skyformat99/IoT256/V2.0.1/doc/结构尺寸.jpg

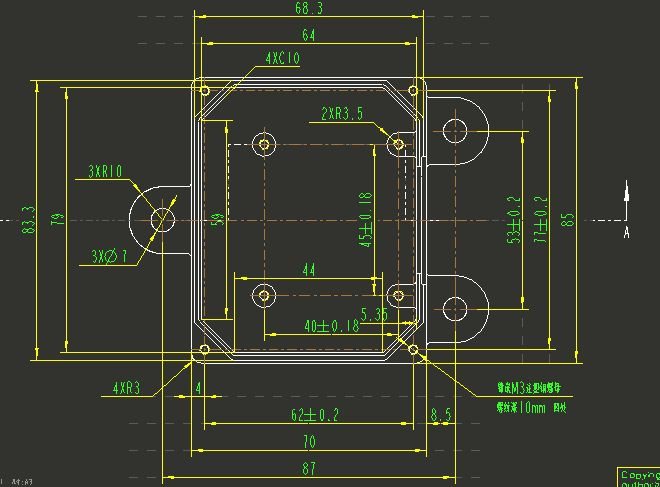
V2.0.1/doc/结构尺寸.jpg
