skyformat99/IoT256/V2.0.1/sch/versionLog.txt

1.PTA4 不能用，系统NMI pin

2. WIFI 16脚接地 （IO15）

3. PTC0图纸方向画反了

4. GPS 天线改成有源 
5.缺少B340A， 54331不工作。
6. R6 改小。 有时候串口输入低电平降不下来。0 欧？
RS232电平转换芯片处于工作状态输出或高或低，会影响HOST电平。低电平异常，可尝试再MCU端对地接个电阻试下。 

TPS54331D 6pin接地电阻为49.9K，图中为4.99K
