skyformat99/IoT256/V1.0.2/doc/VersionLog.txt

1. 在原来TPS54331输出电压3.5V基础上增加到3.8V，3K电阻并24k
2. 输出增加负载160ohm 0805电阻
3. 输出电容47uF x 2

复位电路
拆R17，U5_P8接U1_P26
