skyformat99/IoT256/V2.0.1/sch/IoT module_V2.0.1_BOM.xlsx

IoT module_V2.0.1_BOM
DNP:Do Not Place,不需配料焊接！
序号 | 数量 | 位号 | 型号 | 数值 | 描述 | 厂家 | DNP
1 | 4 | C1,C2,C3,C4 | CL05C270JB5NNNC | 270 | 27pF, 50V, 0402, COG, 5% | SAMSUNG | DNP
2 | 4 | C5,C6,C23,C24 | CL32A476KOJNNNE | 476 | 47uF, 16V,1210, X5R, 10% | SAMSUNG
3 | 1 | C7 | CL10A105KO8NNNC | 105 | 1uF, 16V, 0603, X5R, 10% | SAMSUNG
4 | 14 | C8,C9,C13,C17,C19,C25,C26,C28,C33,C35,C36,C42,C44,C45 | CL05B104KO5NNNC | 104 | 100nF, 16V, 0402, X7R, 10% | SAMSUNG
5 | 6 | C10,C11,C12,C14,C15,C16 | CL05C220JB5NNNC | 220 | 22pF, 50V, 0402, COG, 5% | SAMSUNG
6 | 3 | C18,C40,C41 | CL10A106MP8NNNC | 106 | 10uF, 10V, 0603, X5R, 20% | SAMSUNG
7 | 4 | C20,C22,C38,C39 | CL05C330JB5NNNC | 330 | 33pF, 50V, 0402, COG, 5% | SAMSUNG | DNP
8 | 2 | C21,C37 | CL05C120JB5NNNC | 120 | 12pF, 50V, 0402, COG, 5% | SAMSUNG | DNP
9 | 3 | C27,C29,C30 | CL32B106KBJNNNE | 106 | 10uF, 50V,1210, X7R, 10% | SAMSUNG
10 | 1 | C31 | CL05B472KB5NNNC | 472 | 4.7nF, 50V, 0402, X7R, 10% | SAMSUNG
11 | 1 | C32 | CL05B104KO5NNNC | 104 | 100nF, 50V, 0603, X7R, 10% | SAMSUNG
12 | 1 | C34 | CL05C390JB5NNNC | 390 | 39pF, 50V, 0402, COG, 5% | SAMSUNG
13 | 1 | C43 | CL05C330JB5NNNC | 330 | 33pF, 50V, 0402, COG, 5% | SAMSUNG
14 | 20 | D1,D2,D4,D5,D6,D7,D8,D9,D10,D11,D12,D15,D18,D19,D22,D23,D24,D25,D26,D27 | PESD3V3U1UB | ESD | ESD 9KV, 3V3, SOD-523 | NXP
15 | 4 | D13,D14,D16,D17 | PESD3V3U1UB | ESD | ESD 9KV, 3V3, SOD-523 | NXP | DNP
16 | 1 | D20 | MMSZ5231BT1G | ESD | ESD 9KV, 5V1, SOD-123 | NXP
17 | 1 | D21 | B340A | B340A | 3.0A SURFACE MOUNT SCHOTTKY | DIODES
18 | 1 | FB1 | BLM18AG331SN1D | BLM18AG331SN1D | BLM18AG331SN1D | Murata
19 | 1 | F1 | SMD1210P200TF | SMD200 | 1210, 2A, 6V
20 | 2 | J1,J2 | IPX | XS_IPX
21 | 1 | J3 |  | CON2X9
22 | 2 | J4,J10 |  | CON5
23 | 1 | J5 | 54819-0572 | MINI_USB |  | Molex, LLC
24 | 1 | J6 |  | PWR_SW
25 | 1 | J7 |  | CON5 |  |  | DNP
26 | 1 | J9 |  | PWR_SW |  |  | DNP
27 | 1 | J11 |  | SIM_NANO_12R1X14 | 翻盖 NANO SIM卡座 卡槽 6P, 12.1 x 14
28 | 1 | L1 | IHLP2525CZER6R8M01 | 6.8uH | 6.8uH, 7*7, 4.5A | VISHAY
29 | 1 | L2 | IHLP2020BZER4R7M01 | 4.7uH | 4.7uH, 5.2*5.5, 2.8A | VISHAY
30 | 1 | L3 | LQW18AN27NJ00 | 27nH | 27nH,440mA, 0603,5% | murata
31 | 4 | Q1,Q2,Q3,Q4 | DTC114TK | DTC114TET1G | NPN, 50V, 100mA, SOT-23 | OnSemi
32 | 5 | R1,R2,R3,R21,R23 | RC02K 000JT | 0 | 0ohm, 0402, 100ppm, 5% | 风华高科
33 | 11 | R4,R5,R6,R7,R12,R16,R20,R22,R24,R40,R44 | RC02K 102JT | 102 | 1Kohm, 0402, 100ppm, 5% | 风华高科
34 | 6 | R8,R9,R10,R11,R33,R43 | RC02K1003FT | 1003 | 100Kohm, 0402, 100ppm, 1% | 风华高科
35 | 4 | R13,R25,R28,R41 | RC02K 562JT | 562 | 5.6Kohm, 0402, 100ppm, 5% | 风华高科
36 | 2 | R14,R15 | RC02K 220JT | 220 | 22ohm, 0402, 100ppm, 5% | 风华高科
37 | 6 | R17,R18,R19,R27,R29,R32 | RC02K 510JT | 51R | 51ohm, 0402, 100ppm, 5% | 风华高科
38 | 2 | R26,R30 | RC02K 000JT | 0 | 0ohm, 0402, 100ppm, 5% | 风华高科 | DNP
39 | 2 | R31,R34 | RC02K 1002FT | 1002 | 10Kohm, 0402, 100ppm, 1% | 风华高科
40 | 2 | R35,R39 | RC02K 1002FT | 1002 | 10Kohm, 0402, 100ppm, 1% | 风华高科 | DNP
41 | 1 | R36 | RC02K 000JT | 0 | 0ohm, 0402, 100ppm, 5% | 风华高科 | DNP
42 | 1 | R37 | RC02K4992FT | 4992 | 49.9Kohm, 0402, 100ppm, 1% | 风华高科
43 | 1 | R38 | RC02K 2491FT | 2491 | 2.49Kohm, 0402, 100ppm, 1% | 风华高科
44 | 1 | R42 | RC02K5623FT | 5623 | 562Kohm, 0402, 100ppm, 1% | 风华高科
45 | 1 | R45 | RC02K 100JT | 100 | 10ohm, 0402, 100ppm, 5% | 风华高科
46 | 1 | SW1 |  | SPST-2PIN | 4x3mm switch, 2pns, SMD
47 | 1 | TP1 | DNP | DB_UART_TX | DNP | NONE | DNP
48 | 1 | U1 | SAFFB1G56KB0F0A | SAFFB1G56KB0F0A | 1109, BPF, GPS,GLONASS_BEIDOU | MURATA
49 | 1 | U2 |  | SIM868
50 | 1 | U3 | PRTR5V0U2X | PRTR5V0U2X | TVS | NXP
51 | 1 | U4 | M2M Card | SIM_QFN5X6-8 | M2M Card
52 | 1 | U5 | SN74CBTLV3257RGY | SN74CBTLV3257RGY | 4-Bit 1-of-2 FET Multiplexe | TI
53 | 1 | U6 | ESP-12F | ESP-12F | WIFI Moudle | AnKexin
54 | 1 | U7 | TXB0108RGYR | TXB0108RGYR | 8-Bit Bidirectional Voltage-Level Shifter | TI
55 | 1 | U8 | TPS54331D | TPS54331D | DC-DC, Step Down, 3A, 570KHz, 3.5-28V input | TI
56 | 1 | U9 | MAX3232EUE | MAX3232EUE | RS232 to LVCMOS | MAXIM
57 | 1 | U10 | TPS62200DBV | TPS62200DBV | DC-DC, 300mA, 95% Efficient Step-Down Converter in SOT-23 | TI
58 | 1 | V1 | RED, 0603, LED | V_LED
59 | 4 | V2,V3,V4,V5 | GREEN, 0603, LED | V_LED
