skyformat99/IoT256/V2.0.1/pcb/IoT Moudle V2_0_1.pdf

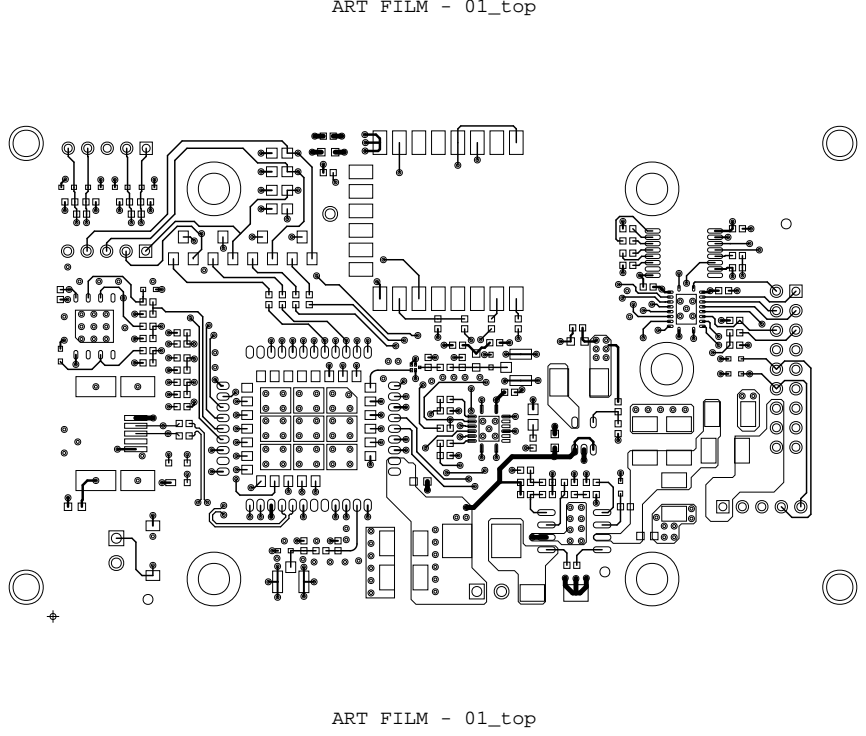
[picture p2: page 1]
ART FILM - 01_top

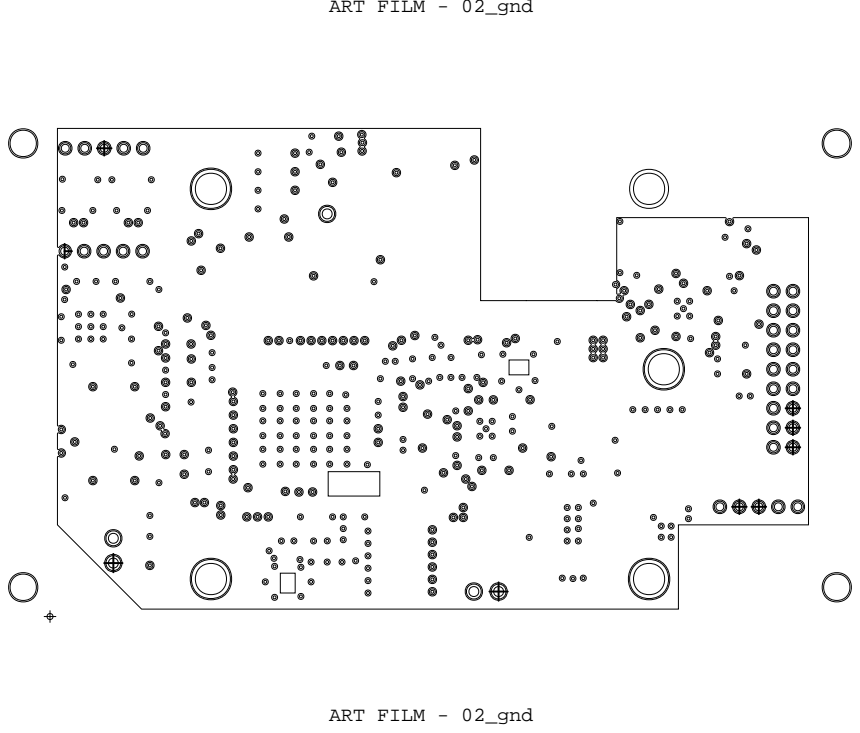
[picture p3: page 2]
ART FILM - 02_gnd

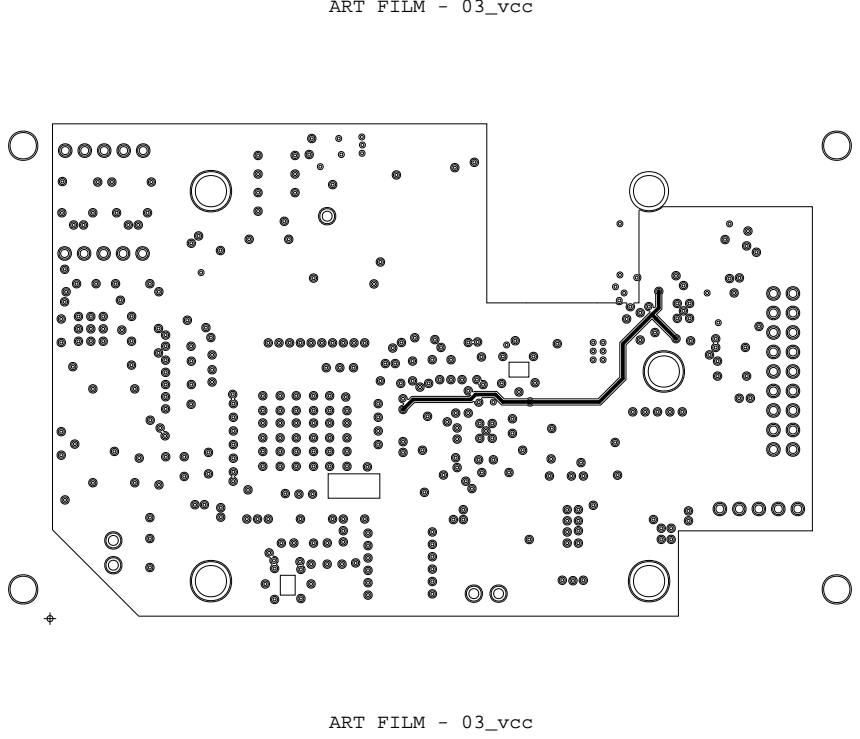
[picture p4: page 3]
ART FILM - 03_vcc

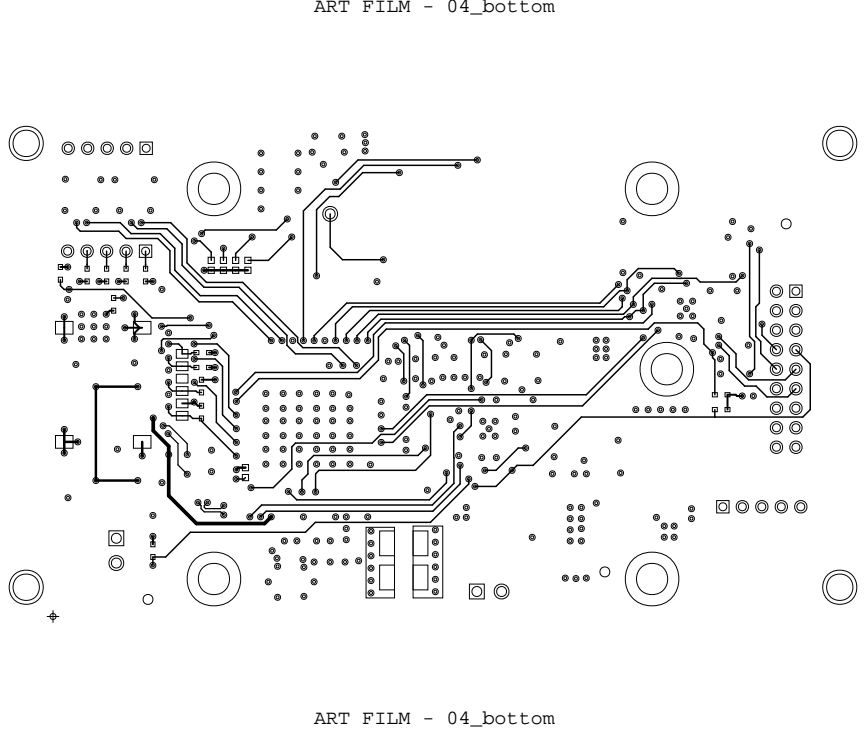
[picture p5: page 4]
ART FILM - 04_bottom

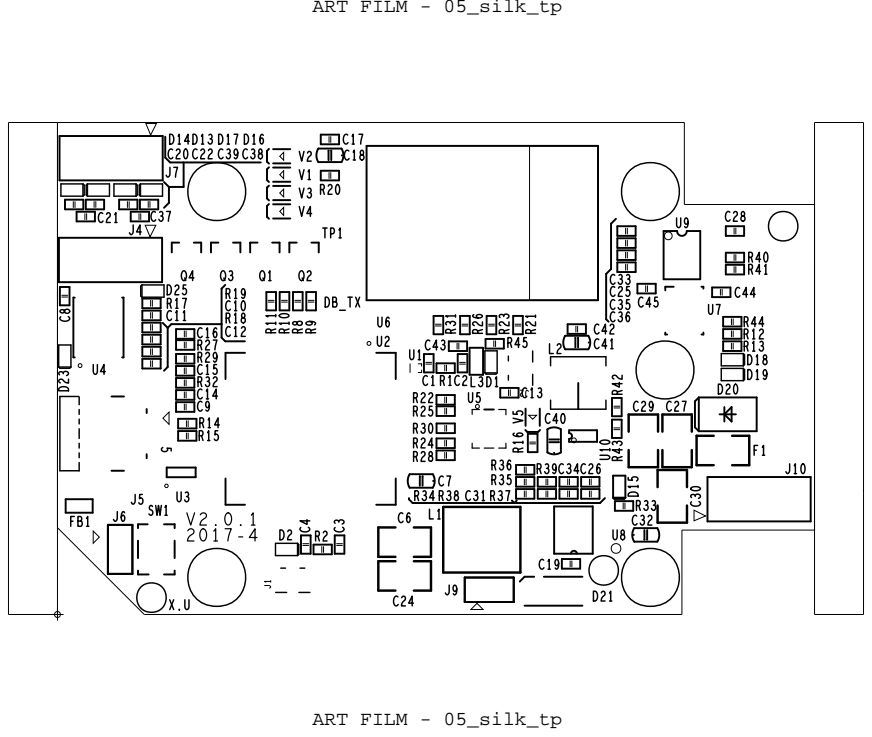
[picture p6: page 5]

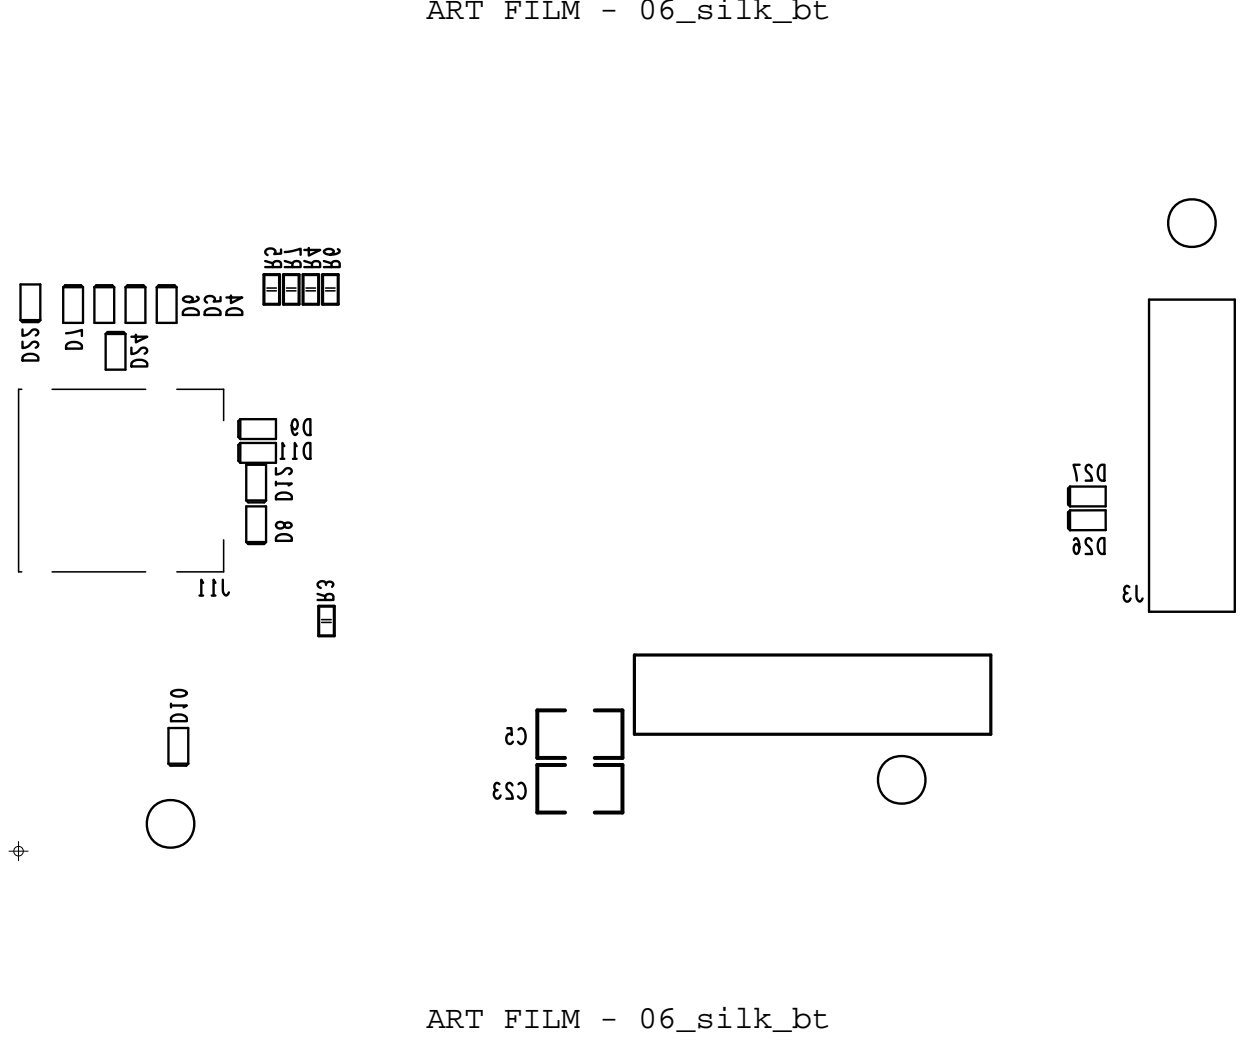
[picture p7: page 6]

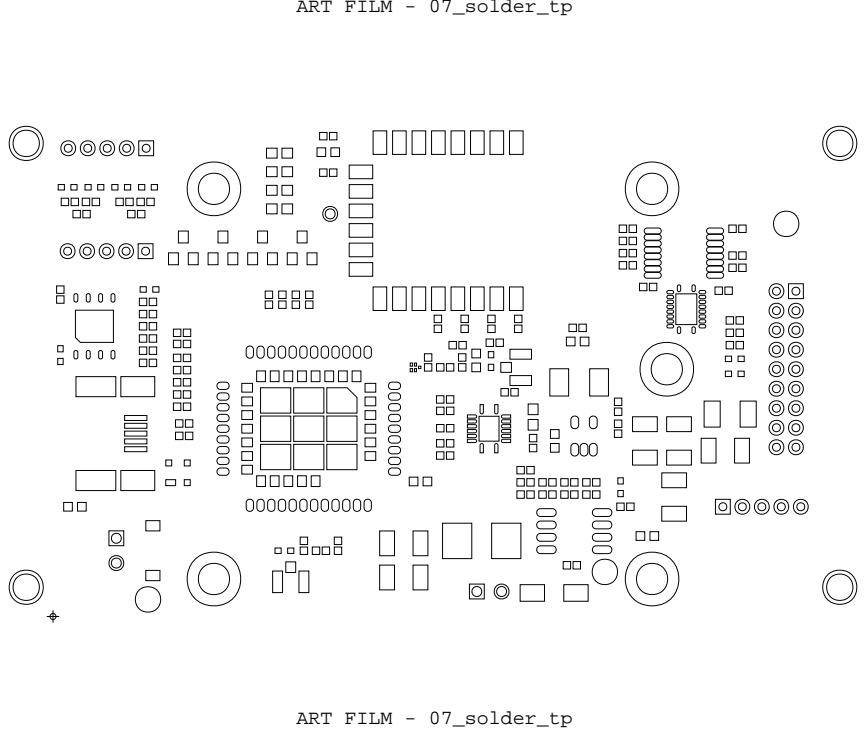
[picture p8: page 7]
ART FILM - 07_solder_tp

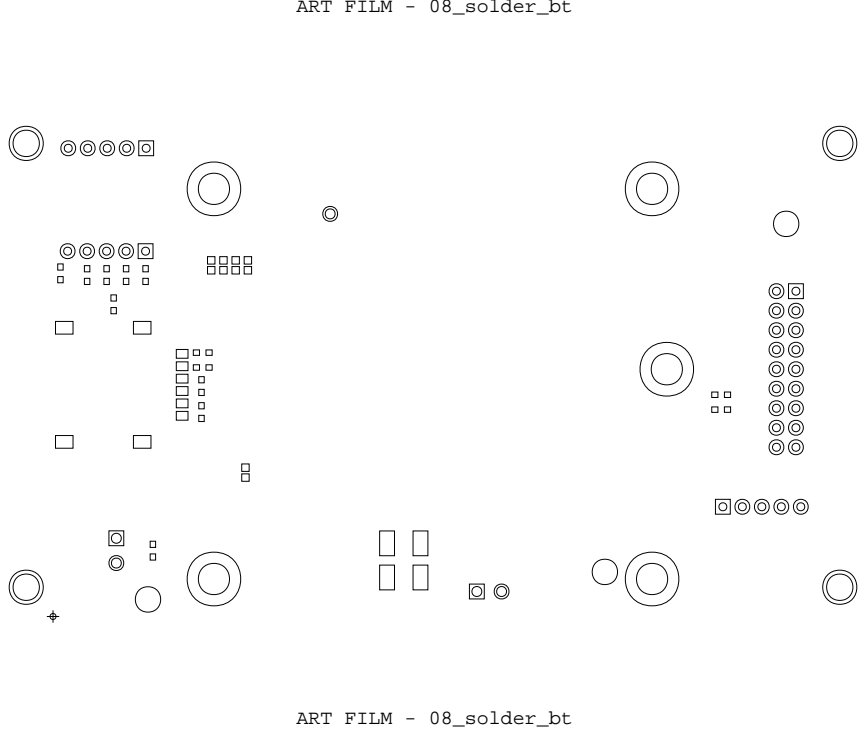
[picture p9: page 8]
ART FILM - 08_solder_bt

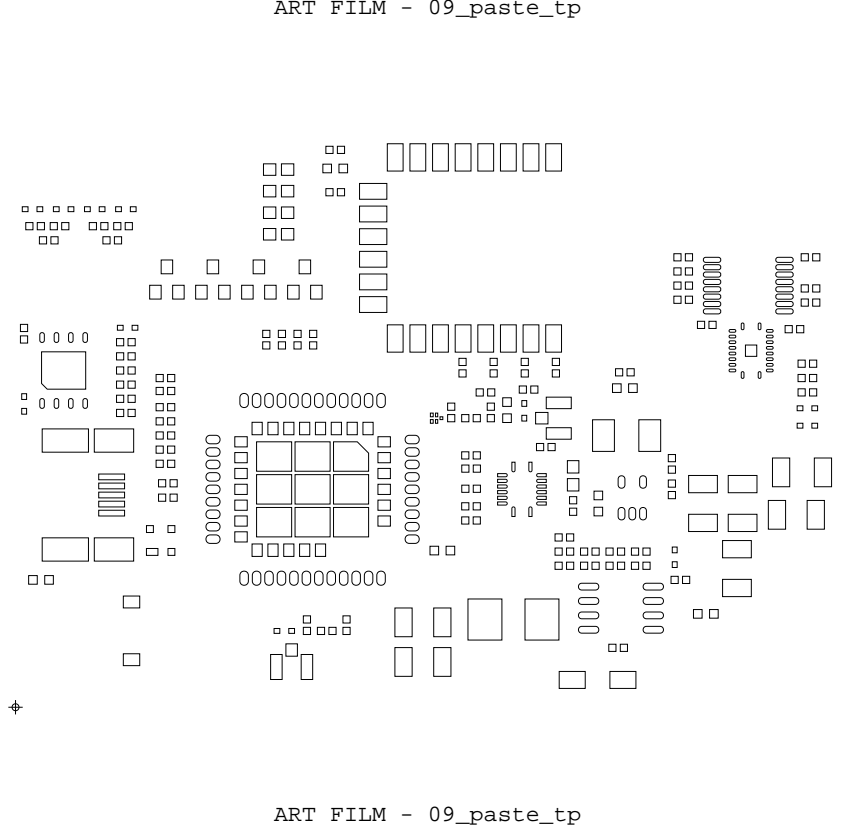
[picture p10: page 9]
ART FILM - 09_paste_tp

ART FILM - 10_paste_bt

ART FILM - 10_paste_bt

ART FILM - v-cut

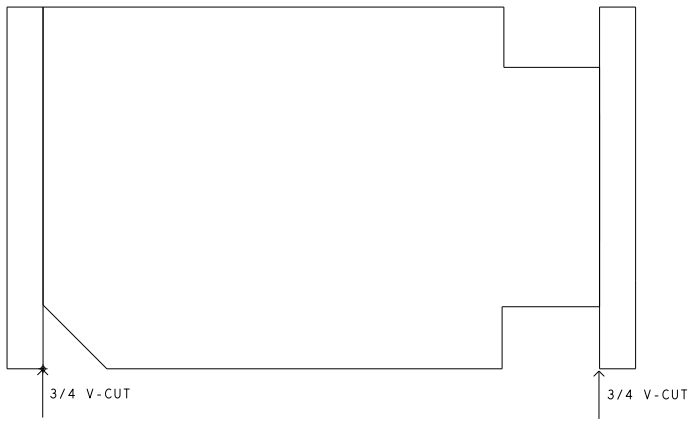
[picture p11: figure]
3/4 V-CUT

ART FILM - v-cut

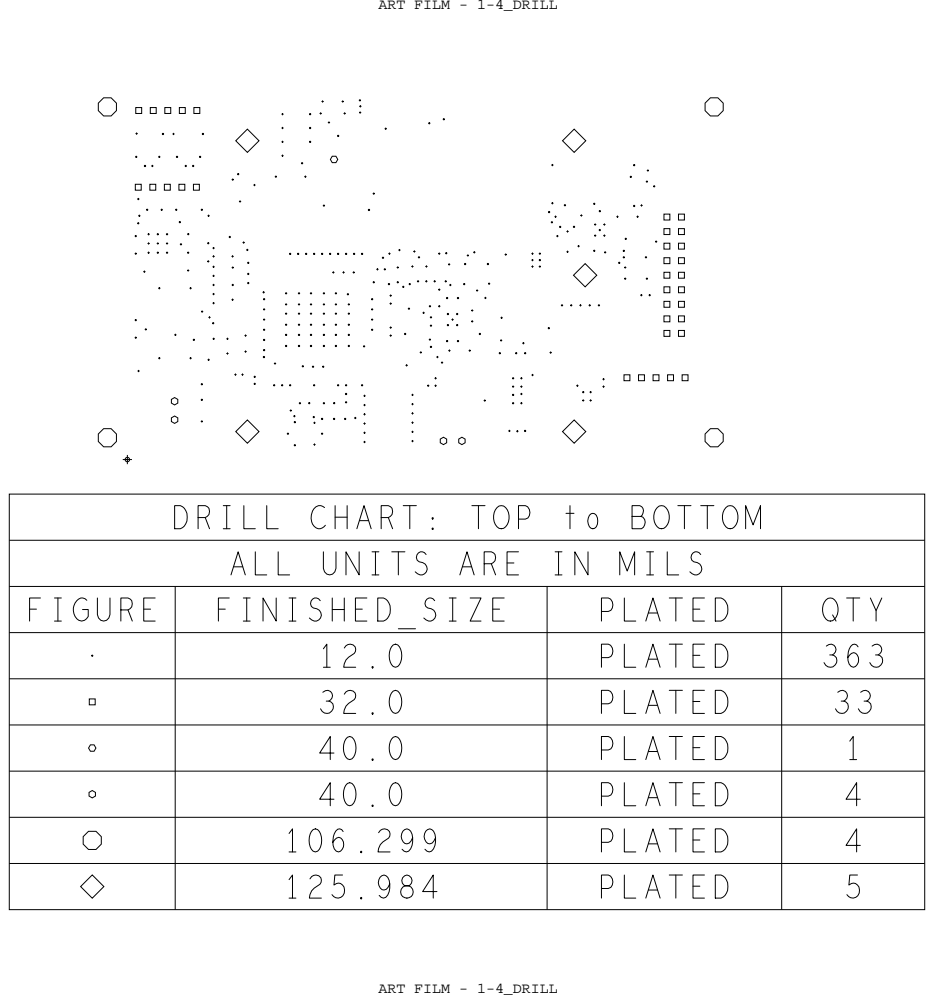
[picture p12: page 12]
ART FILM - 1-4_DRILL; QTY 363; PLATED PLATED PLATED PLATED PLATED PLATED PLATED; ALL UNITS ARE IN MILS FINISHED_SIZE; DRILL CHART: TOP to BOTTOM; FIGURE

88.65
78.99

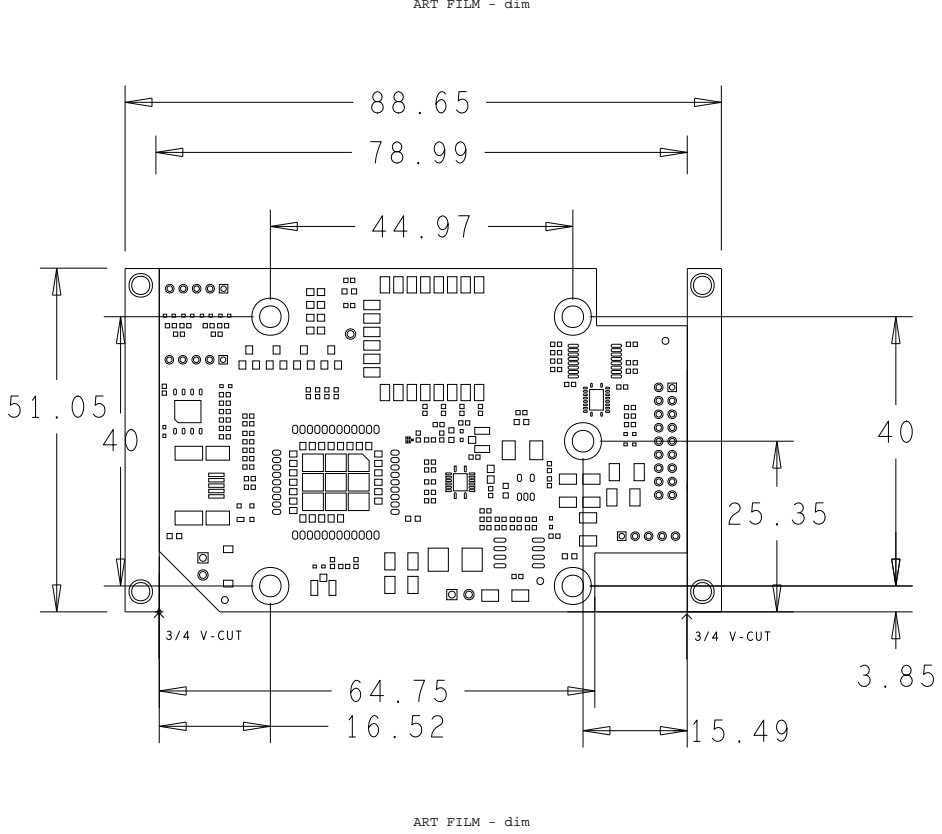
[picture p13: page 13]
3/4 V-CUT

ART FILM - dim
