skyformat99/IoT256/V1.0.3/forProduce/IoT Moudle V1_0_3_pcb.pdf

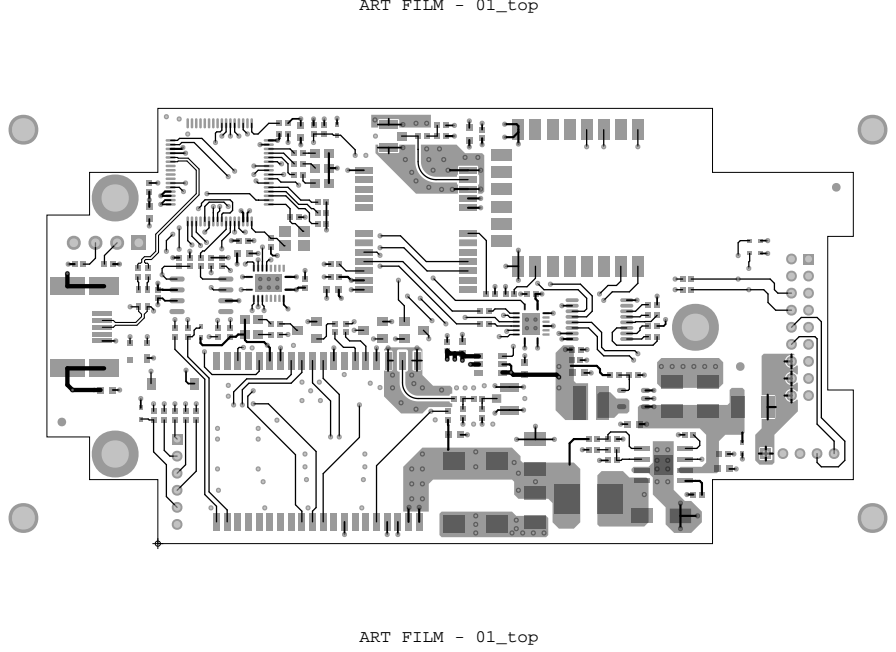
[picture p14: page 1]
ART FILM - 01_top

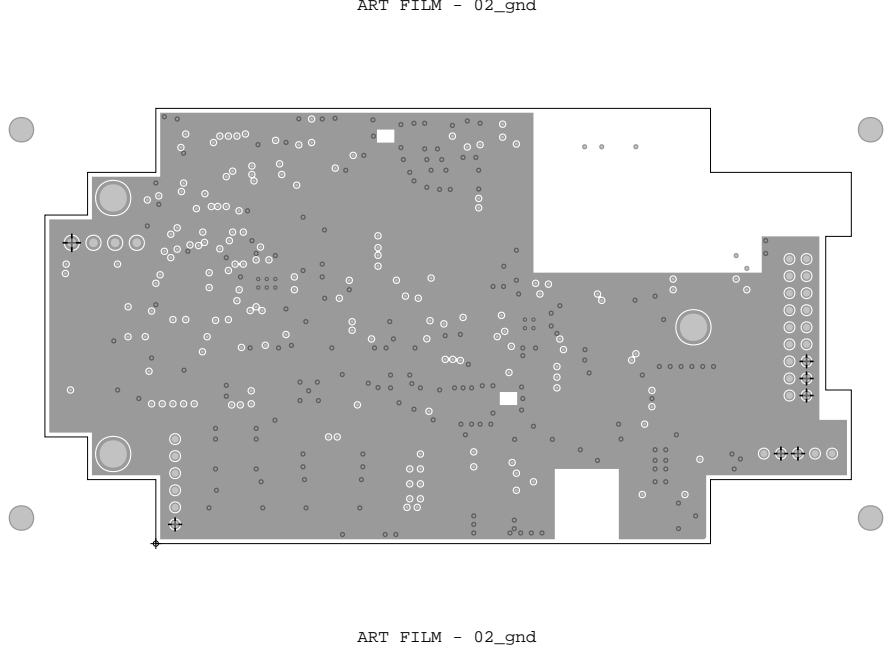
[picture p15: page 2]
ART FILM - 02_gnd

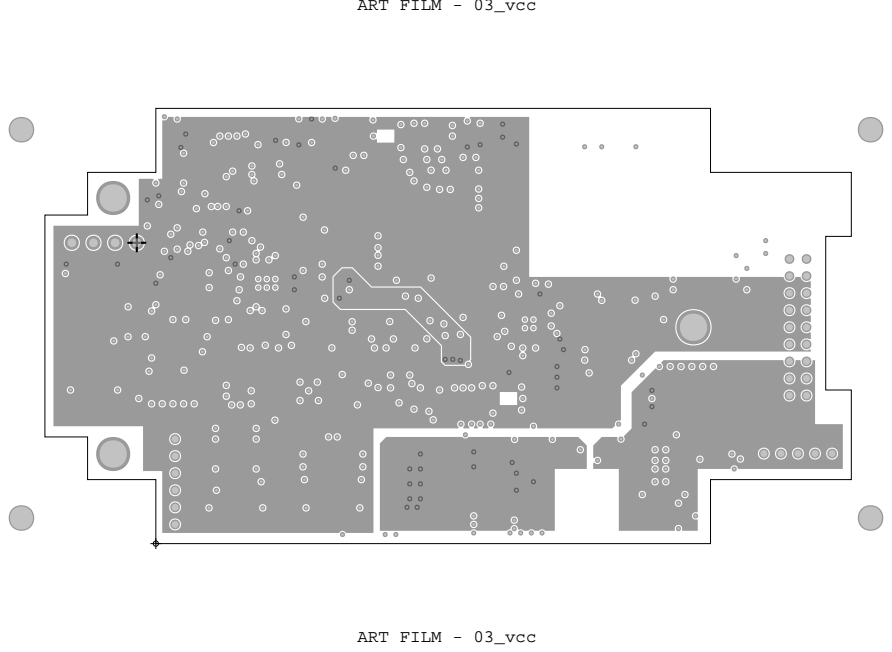
[picture p16: page 3]
ART FILM - 03_vcc

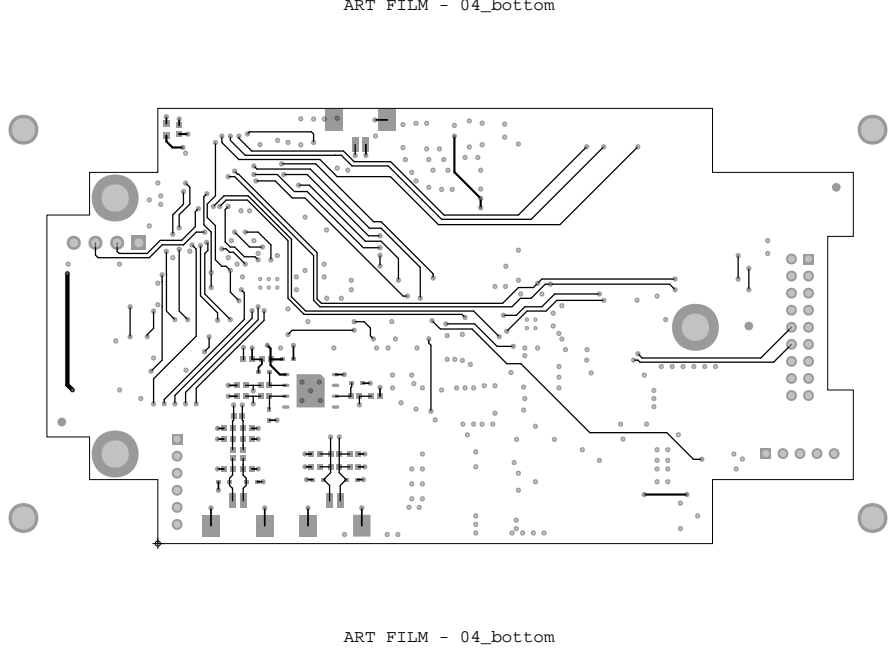
[picture p17: page 4]
ART FILM - 04_bottom

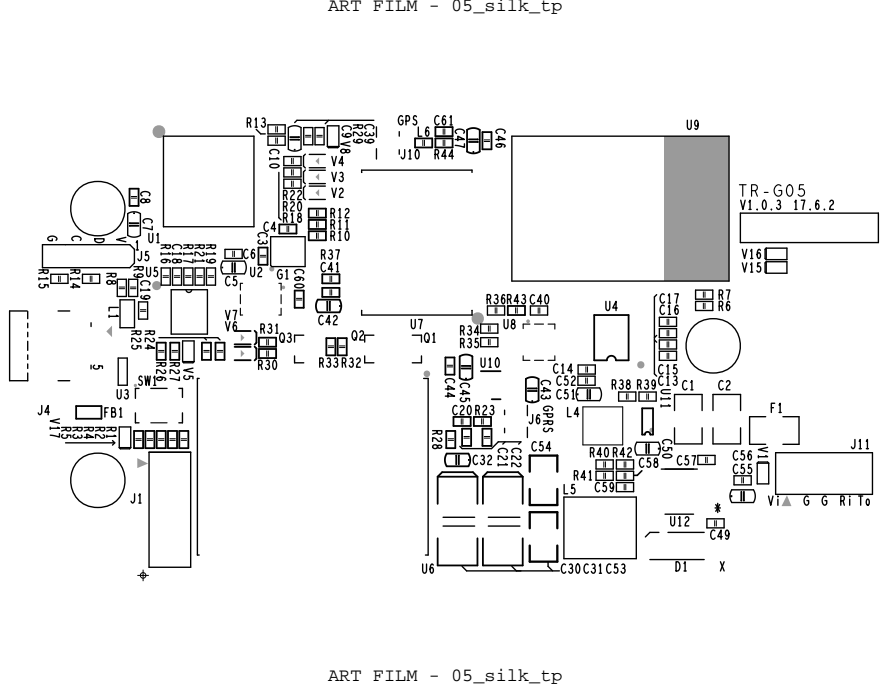
[picture p18: page 5]

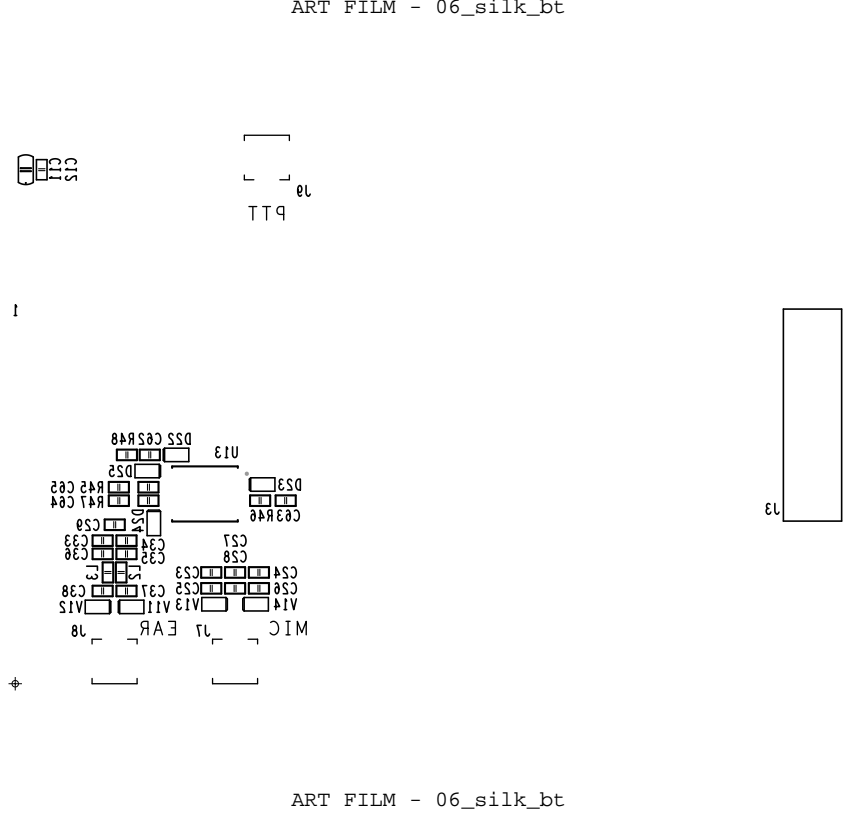
[picture p19: page 6]

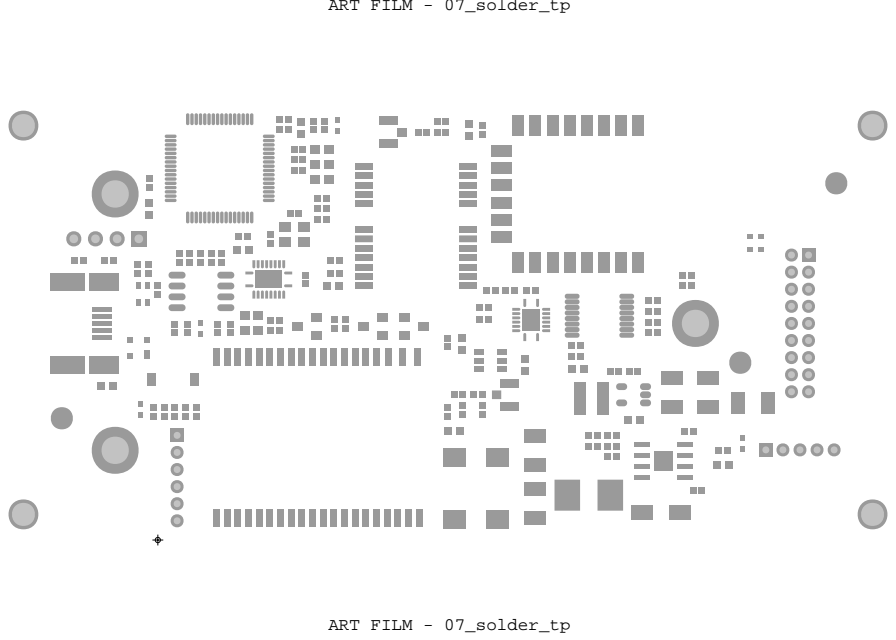
[picture p20: page 7]
ART FILM - 07_solder_tp

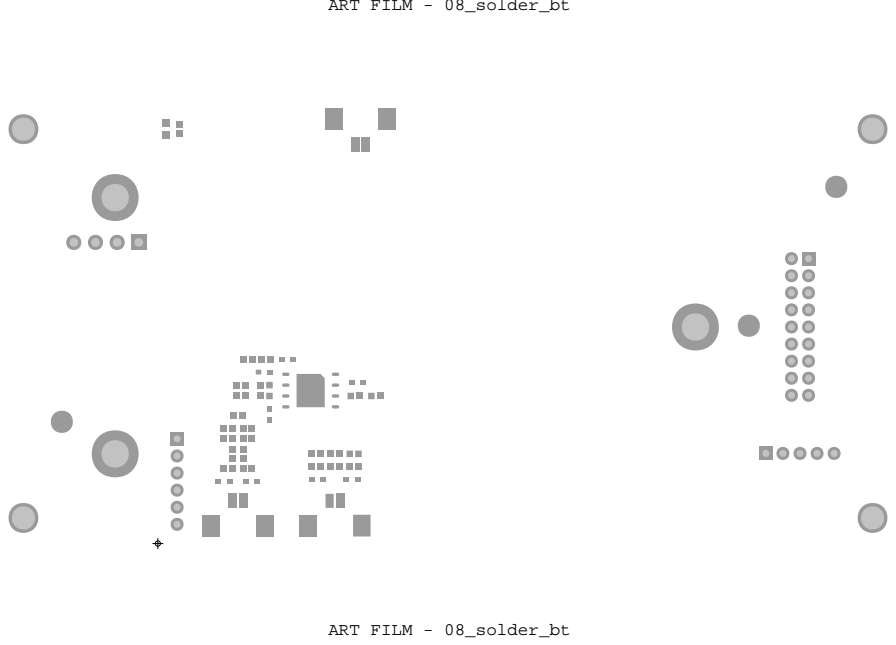
[picture p21: page 8]
ART FILM - 08_solder_bt

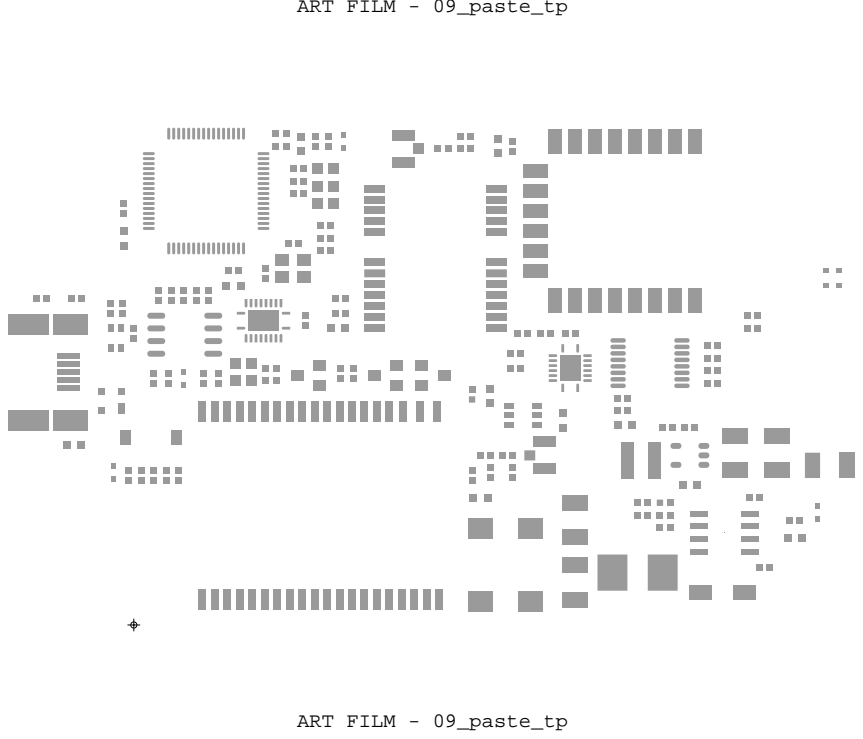
[picture p22: page 9]
ART FILM - 09_paste_tp

ART FILM - 10_paste_bt

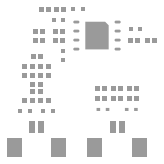
[picture p23: figure]

ART FILM - 10_paste_bt

ART FILM - v-cut

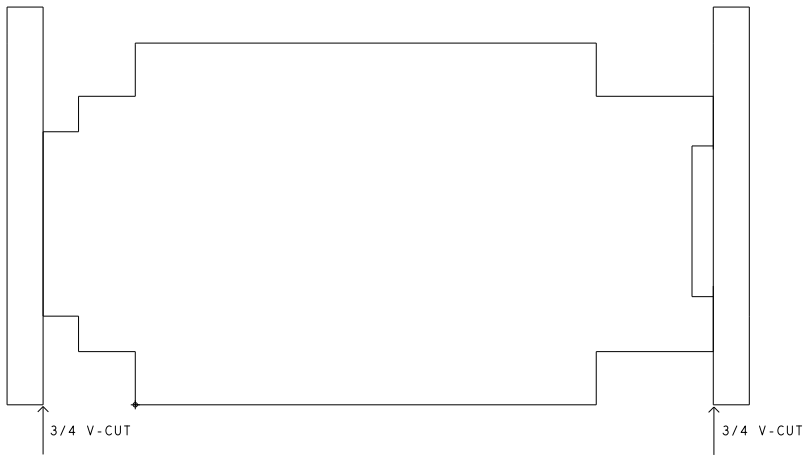
[picture p24: figure]
3/4 V-CUT

ART FILM - v-cut

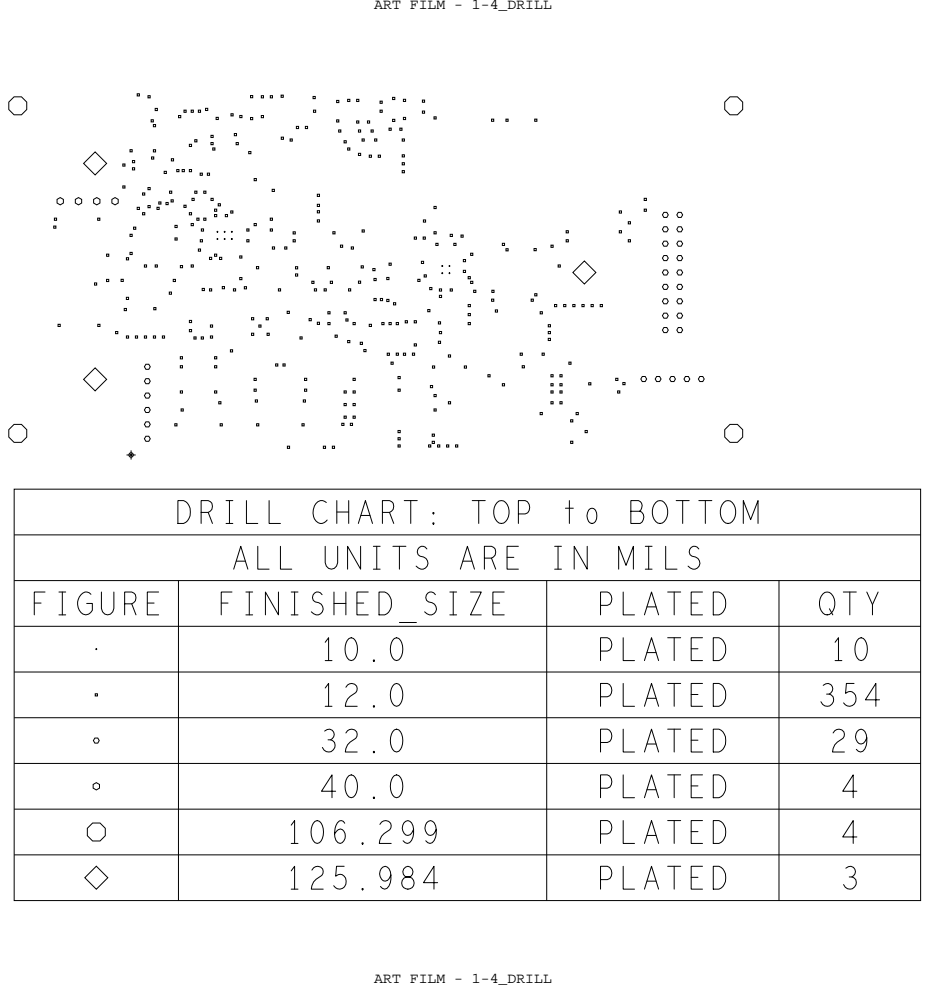
[picture p25: page 12]
ART FILM - 1-4_DRILL; QTY; PLATED PLATED PLATED PLATED PLATED PLATED PLATED; ALL UNITS ARE IN MILS FINISHED_SIZE; DRILL CHART: TOP to BOTTOM; FIGURE

40.5

86.5

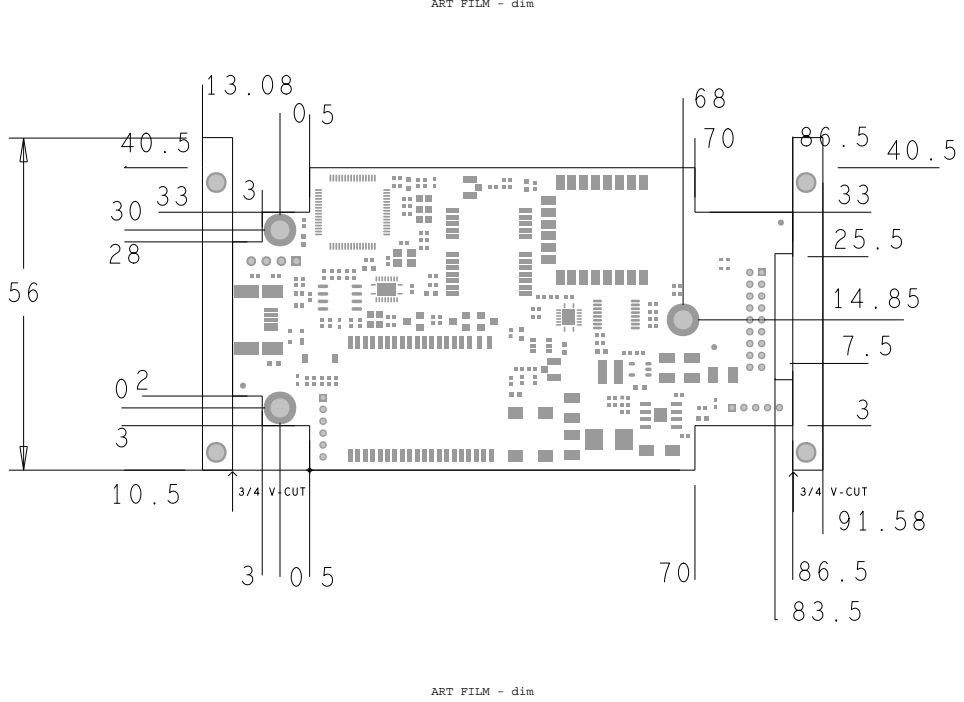
[picture p26: page 13]
V-CUT

ART FILM - dim
