skyformat99/IoT256/V1.0.2/pcb/IoT Moudle V1_0_2.pdf

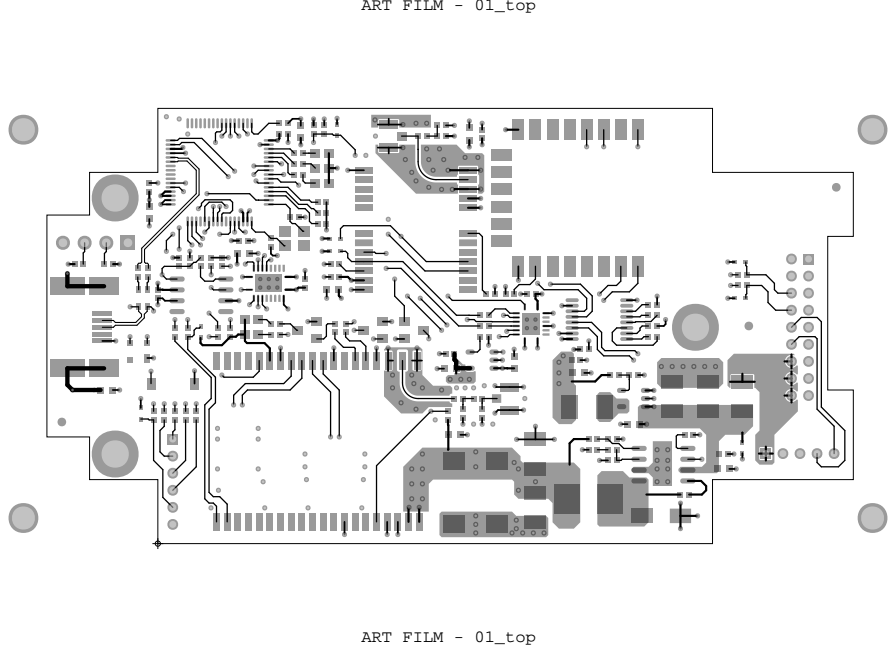
[picture p27: page 1]
ART FILM - 01_top

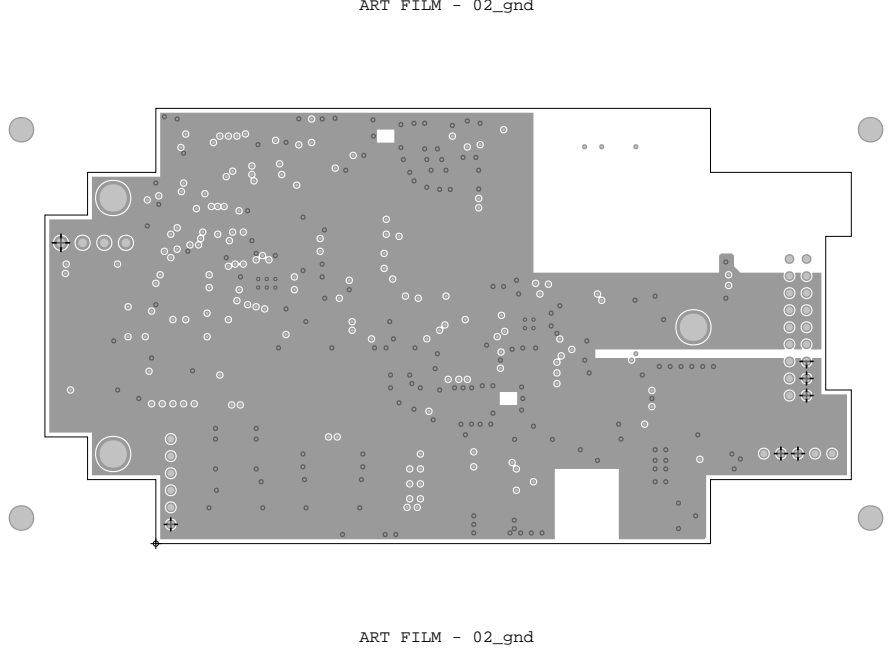
[picture p28: page 2]
ART FILM - 02_gnd

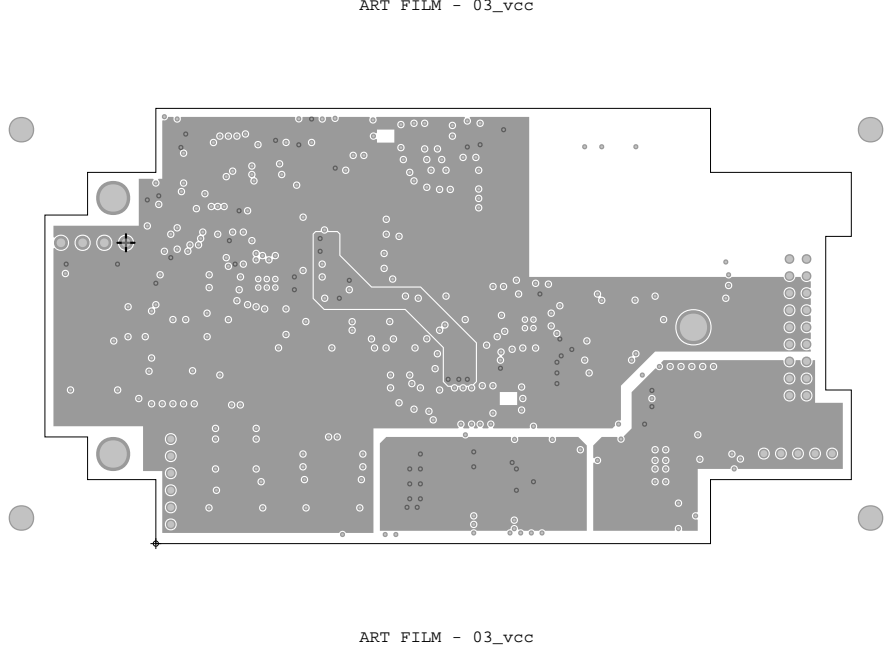
[picture p29: page 3]
ART FILM - 03_vcc

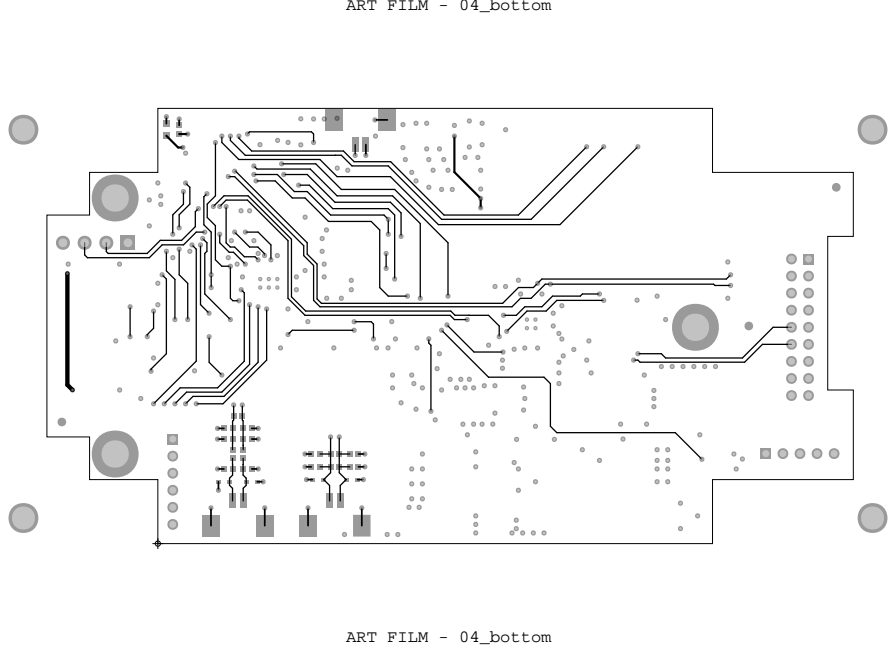
[picture p30: page 4]
ART FILM - 04_bottom

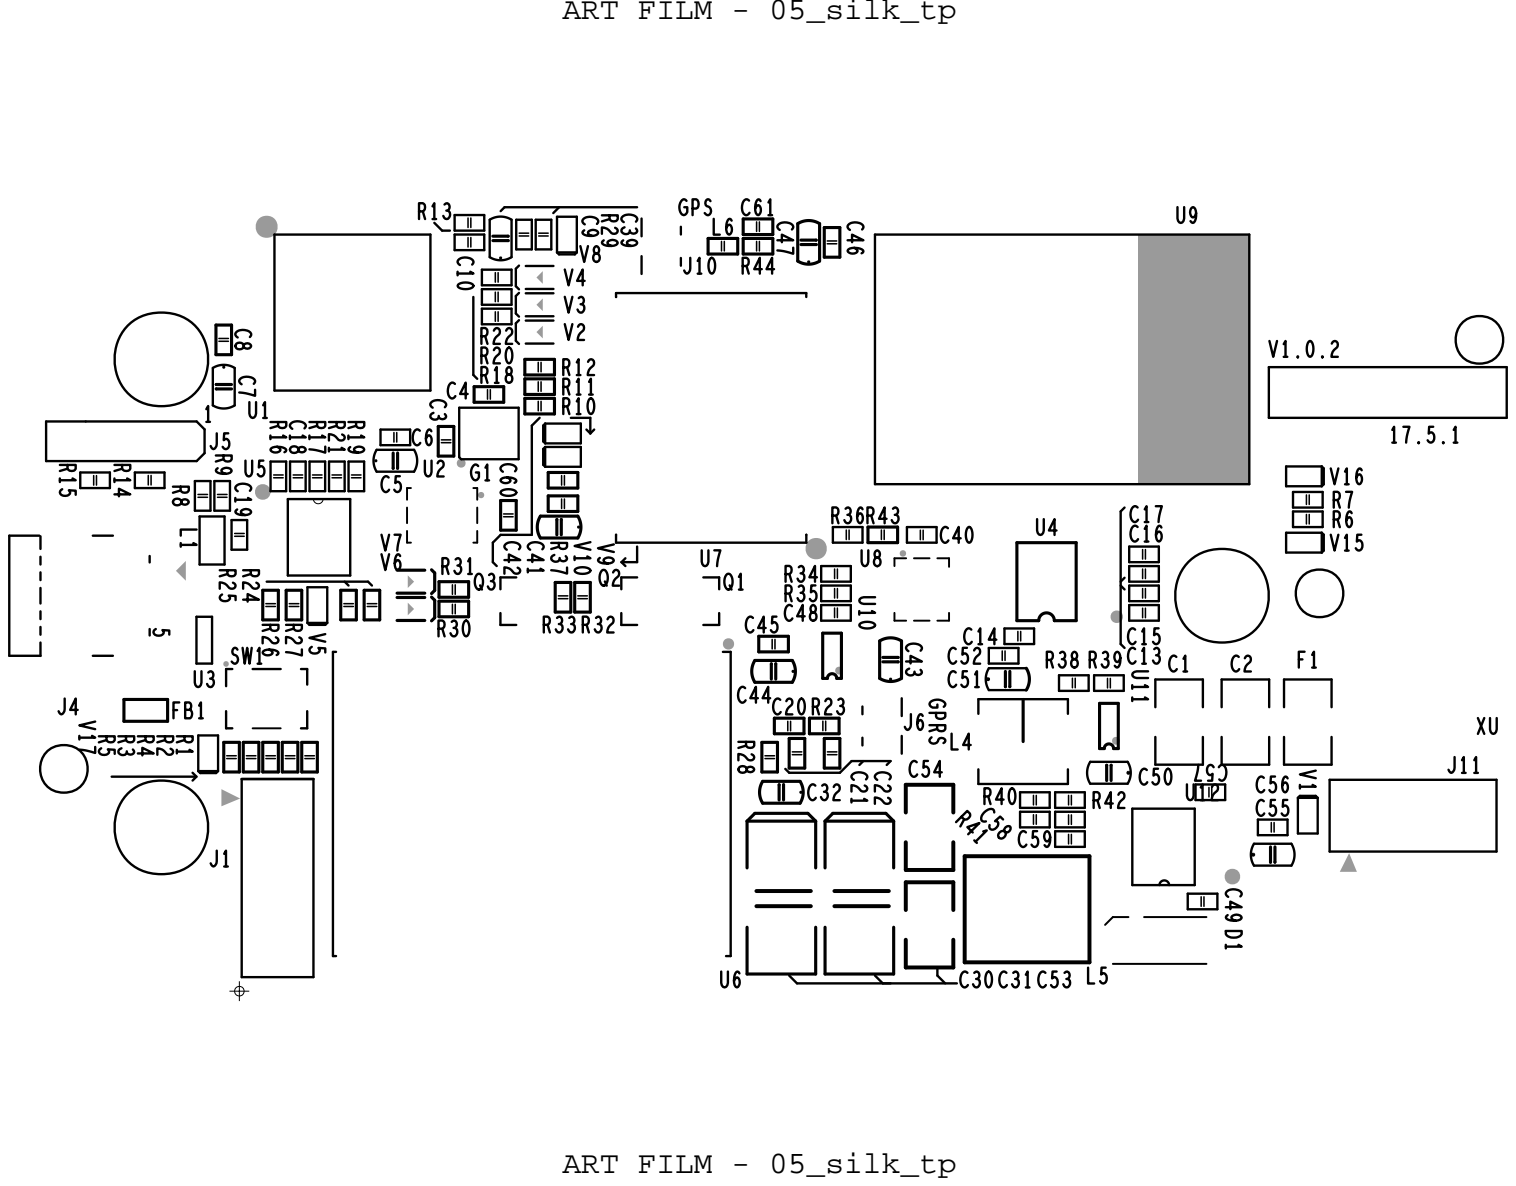
[picture p31: page 5]

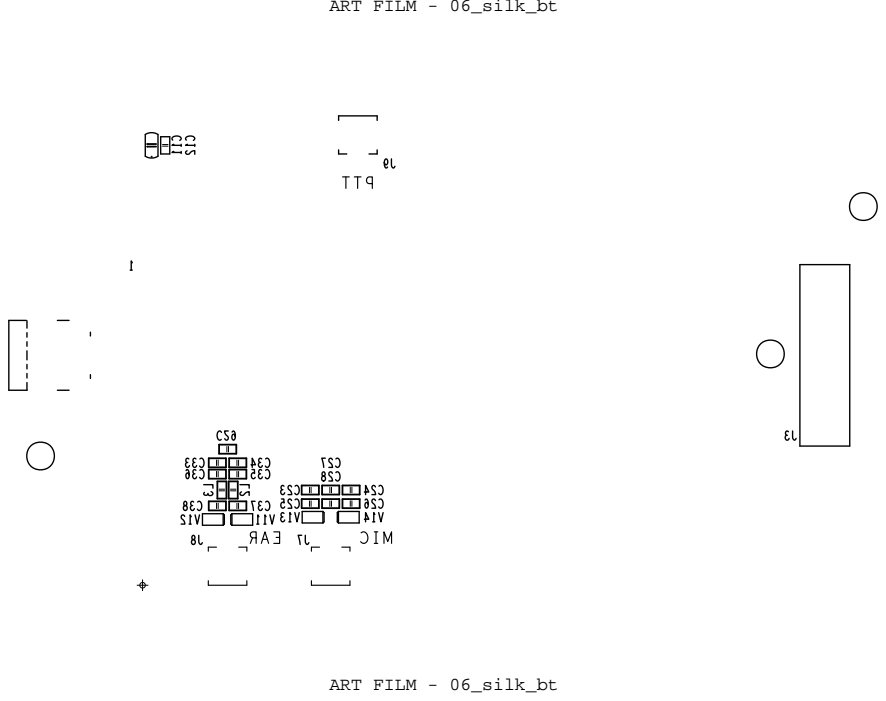
[picture p32: page 6]

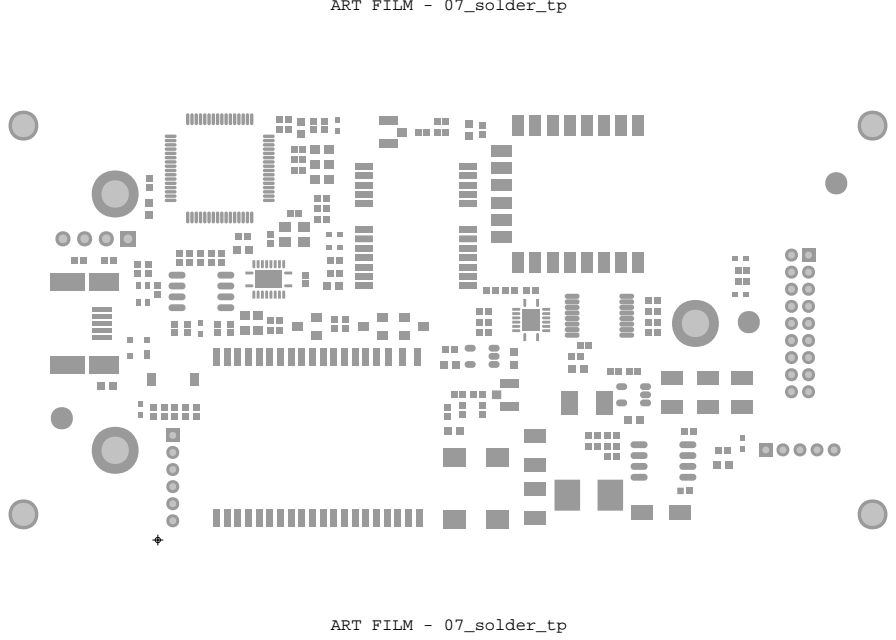
[picture p33: page 7]
ART FILM - 07_solder_tp

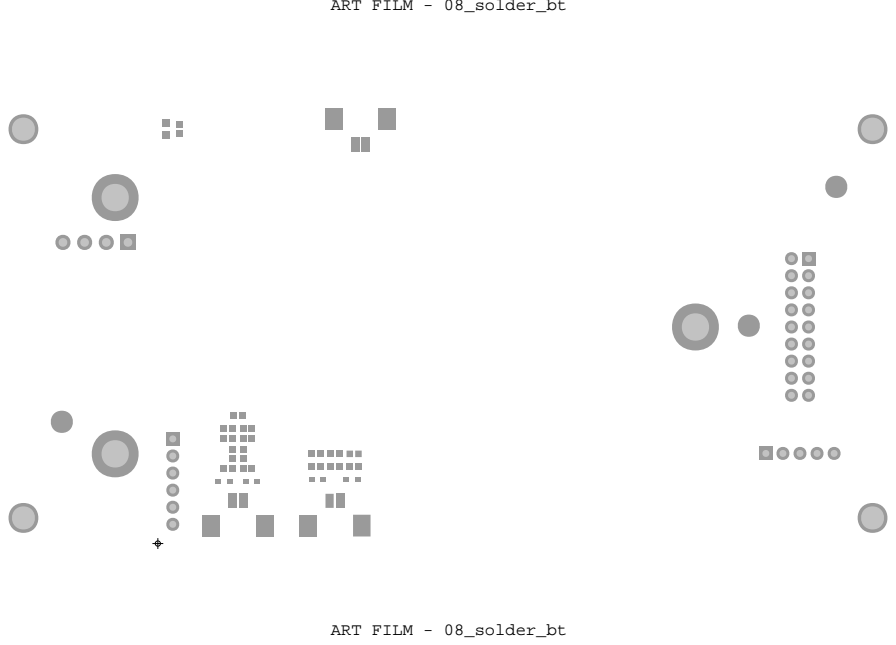
[picture p34: page 8]
ART FILM - 08_solder_bt

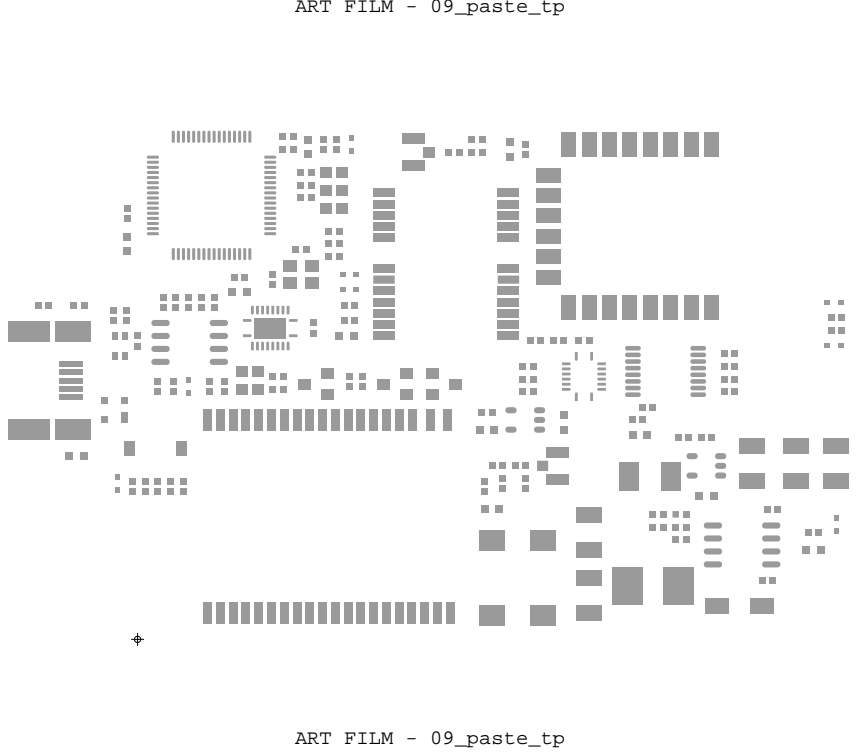
[picture p35: page 9]
ART FILM - 09_paste_tp

ART FILM - 10_paste_bt

ART FILM - 10_paste_bt

ART FILM - v-cut

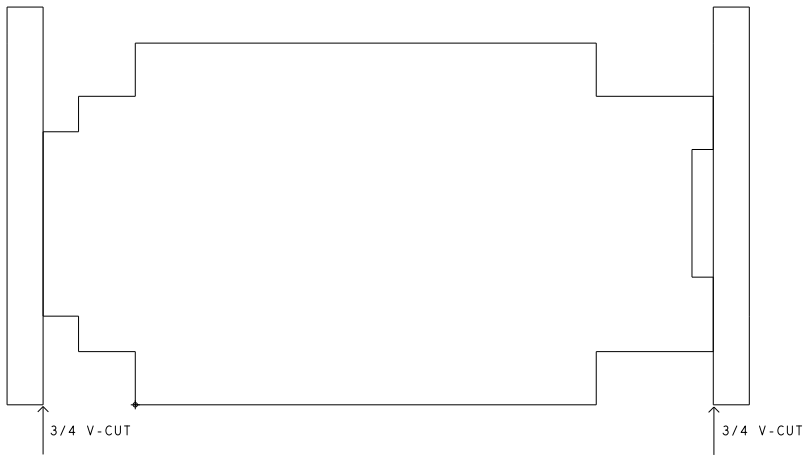
[picture p36: figure]
3/4 V-CUT

ART FILM - v-cut

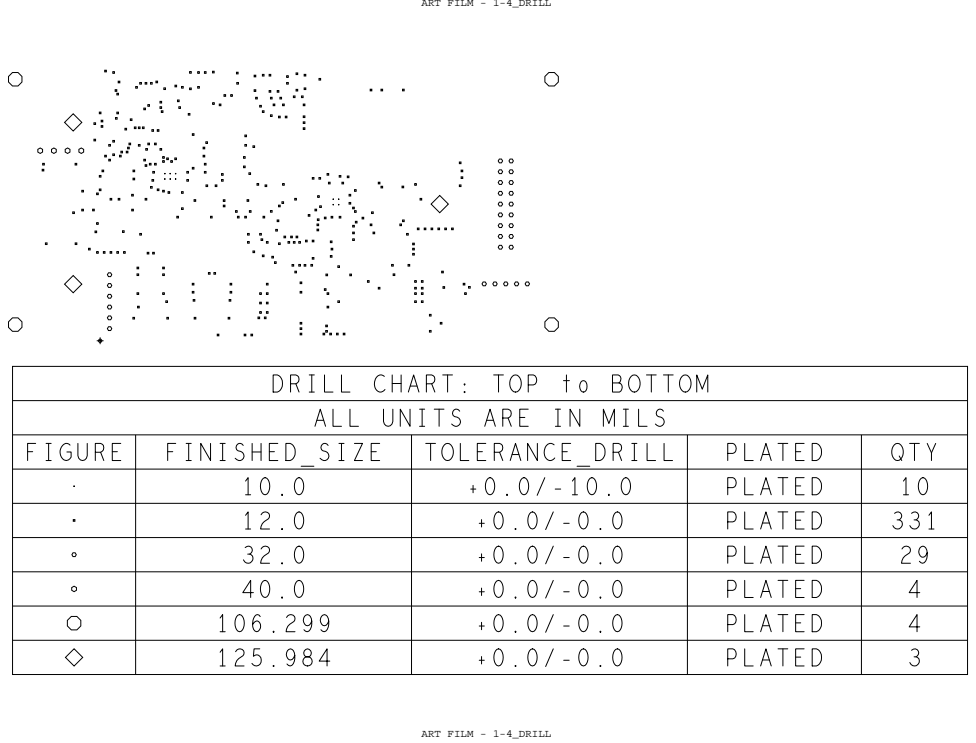
[picture p37: page 12]
ART FILM - 1-4_DRILL; QTY; PLATED PLATED PLATED PLATED PLATED PLATED PLATED; TOLERANCE_DRILL; FIGURE; FINISHED_SIZE

DRILL CHART: TOP to BOTTOM
ALL UNITS ARE IN MILS

40.5

86.5

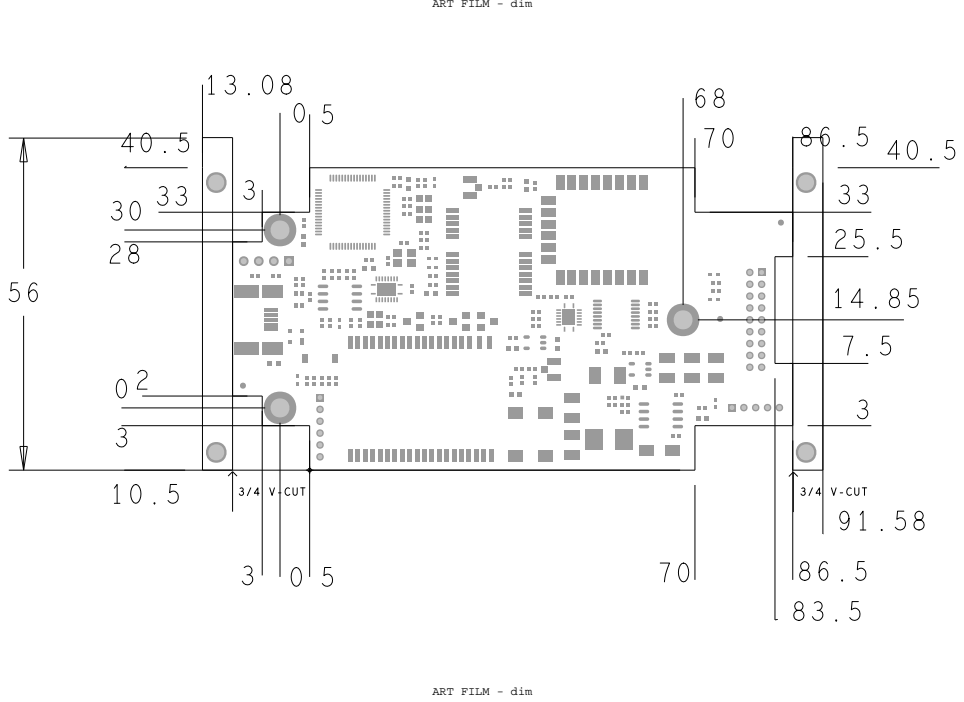
[picture p38: page 13]
V-CUT

ART FILM - dim
