skyformat99/IoT256/(list of files, drawings)

Other design files:
TPS54331_demo/sch/TPS54331_demo.DSN
V1.0.1/sch/IOT MODULE.DSN
V1.0.2/sch/iot module_V1.0.2_SCH.DSN
V1.0.3/sch/iot module_V1.0.3_SCH.DSN
V2.0.1/sch/IoT MODULE_V2_0_1.DSN
