skyformat99/IoT256/(commit log)

2017-05-23 add hardware files
    [IOT MODULE.DSN, IoT MODULE_V2_0_1.DSN, IoT Moudle V1_0_2.brd, IoT Moudle V1_0_3.brd, IoT Moudle V1_1.brd, IoT Moudle V2_0_1.brd, IoT module_V1.1_BOM.xlsx, IoT module_V2.0.1_BOM.xlsx]
2017-05-24 modify sch...
    [IOT MODULE_V1.0.3-BOM.xlsx, IoT Moudle V1_0_3.brd, cases.cfg, iot module_V1.0.2_BOM.xlsx, iot module_V1.0.3_SCH.DSN]
2017-06-06 modify design files
    [IOT MODULE_V1.0.3-BOM.xlsx, IoT Moudle V1_0_3.brd, iot module_V1.0.3_SCH.DSN]
2017-06-13 add sch.pdf, change history message.
    [iot module_V1.0.3_SCH.DSN]
2017-07-01 update all
    [IOT MODULE_V1.0.3-BOM.xlsx, IoT Moudle V1_0_3.brd, iot module_V1.0.3_SCH.DSN]
